alunmorris/Multi-channel-autorange-OLED-voltmeter/schematic/Four-channel-OLED-voltmeter.png

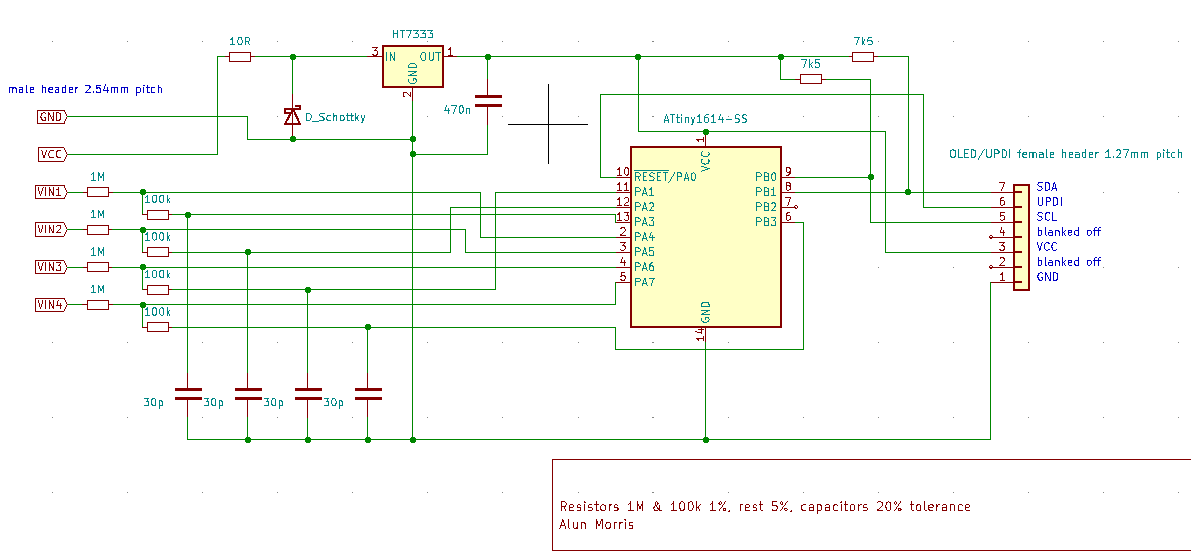
schematic/Four-channel-OLED-voltmeter.png
